helgelangen/TTT4212/Documentation/tex/10_Appendix.tex

\chapter{Schematics and layout}

  \begin{figure}[h]
	  \centering
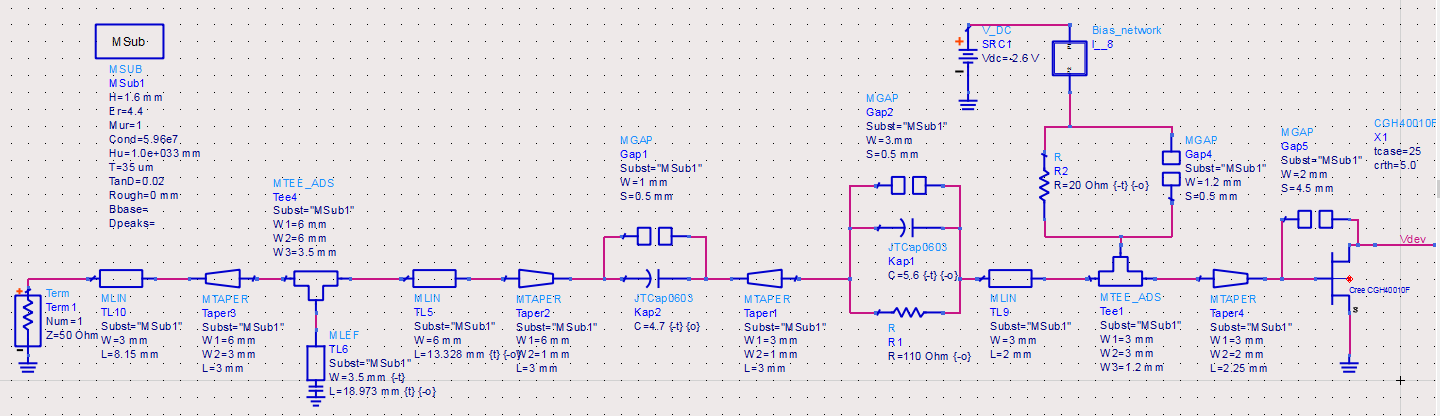
[picture p10: Documentation/img/Circuit_input.PNG]
	  
	  \caption{Input portion of amplifier circuit with S-parameter terminal}
	  \label{fig:Schem_Input}
  \end{figure}

  \begin{figure}[H]
	  \centering
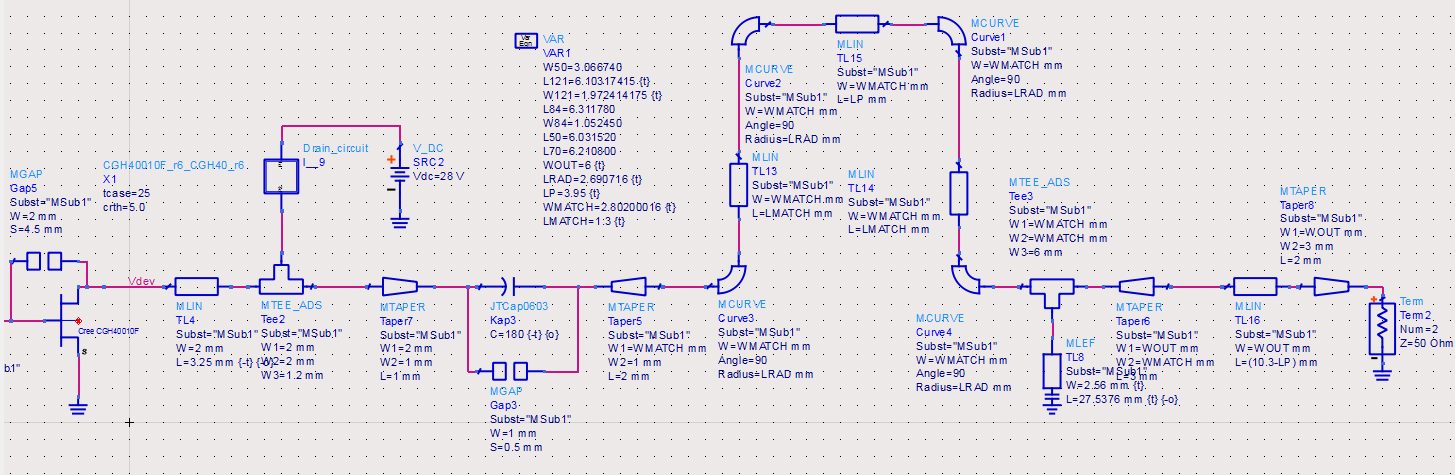
[picture p11: Documentation/img/Circuit_output.PNG]
	  
	  \caption{Output portion of amplifier circuit with S-parameter terminal}
	  \label{fig:Schem_Output}
  \end{figure}

  \begin{figure}[h]
	  \centering
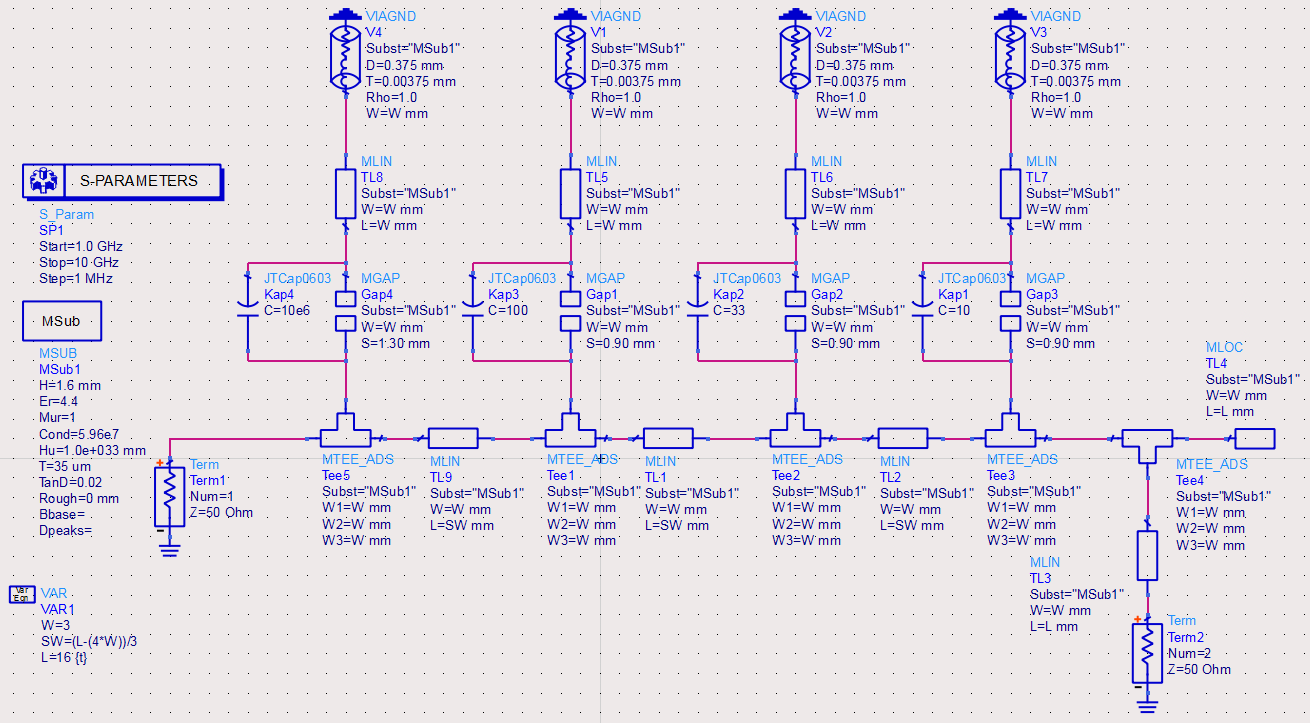
[picture p12: Documentation/Inbox/Bias_filter_two_port.PNG]
	  
	  \caption{Schematics of input and output bias network}
	  \label{fig:Schem_Bias}
  \end{figure}

  \begin{figure}[h]
	  \centering
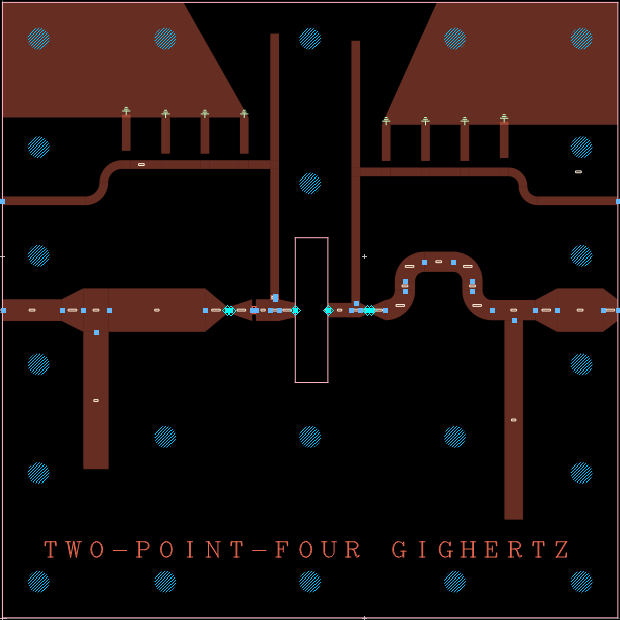
[picture p13: Documentation/img/Layout_ads.PNG]
	  
	  \caption{PCB layout}
	  \label{fig:Layout}
  \end{figure}

\chapter{Additional graphs}

  \begin{figure}[h]
	  \centering
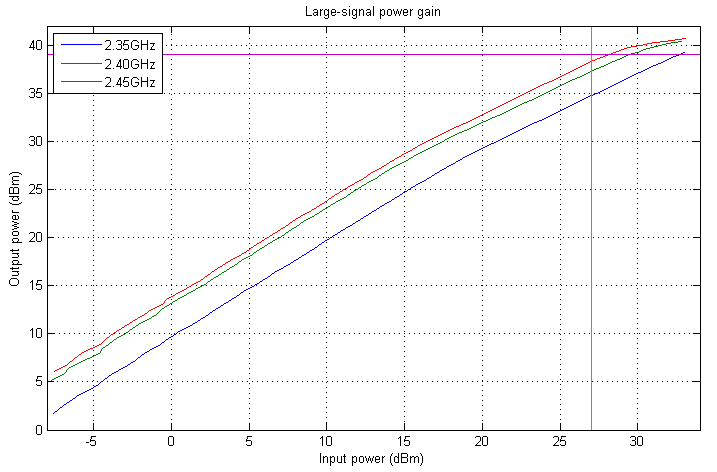
[picture p14: Documentation/img/Power_Out_1tone.png]
	  
	  \caption{Measured output power at three different frequencies}
	  \label{fig:Meas_Pout}
  \end{figure}

  \begin{figure}[H]
	  \centering
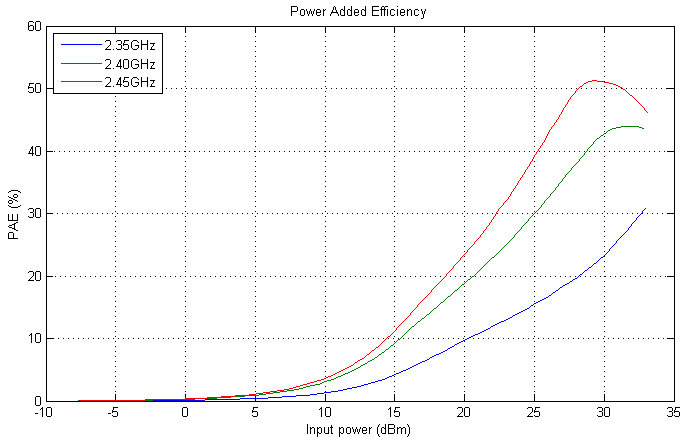
[picture p15: Documentation/img/Power_Added_Efficiency.png]
	  
	  \caption{Measured power added efficiency at three different frequencies}
	  \label{fig:Meas_Pae}
  \end{figure}
