helgelangen/TTT4212/Documentation/tex/title.tex

\begin{titlepage}

	\begin{center}~
		\\[5cm]

		~
		\\[0.3cm]
		\textsc{ Department of Electronics and Telecommunications}~
		\\[2cm]

		{ \huge \bfseries TTT4212 RF/Microwave Design and Measurement Techniques \\[0.5cm]
		Term Project Fall 2014 }~
		\\[1.5cm]

		{ \LARGE J\o rn Fr\o ysa, Helge Langen, Lars-Arne Larsen}
	\end{center}

\end{titlepage}
