helgelangen/TTT4212/Documentation/RF-present.pdf

## Design of power amplifier

- Design choices
- Bias/drain-network
- Stabillity
- Matching
- Layout
- Results

## Design choices

- Class AB
- Efficiency
- Gain
- Stubs for matching

## Bias/drain-network

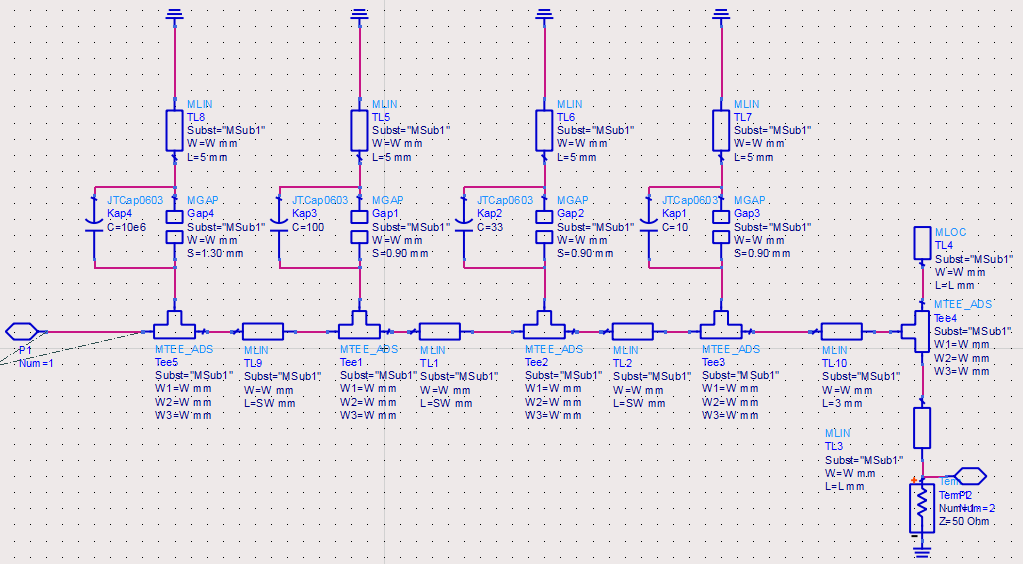
[picture p16: figure]

## Stabillity schematic

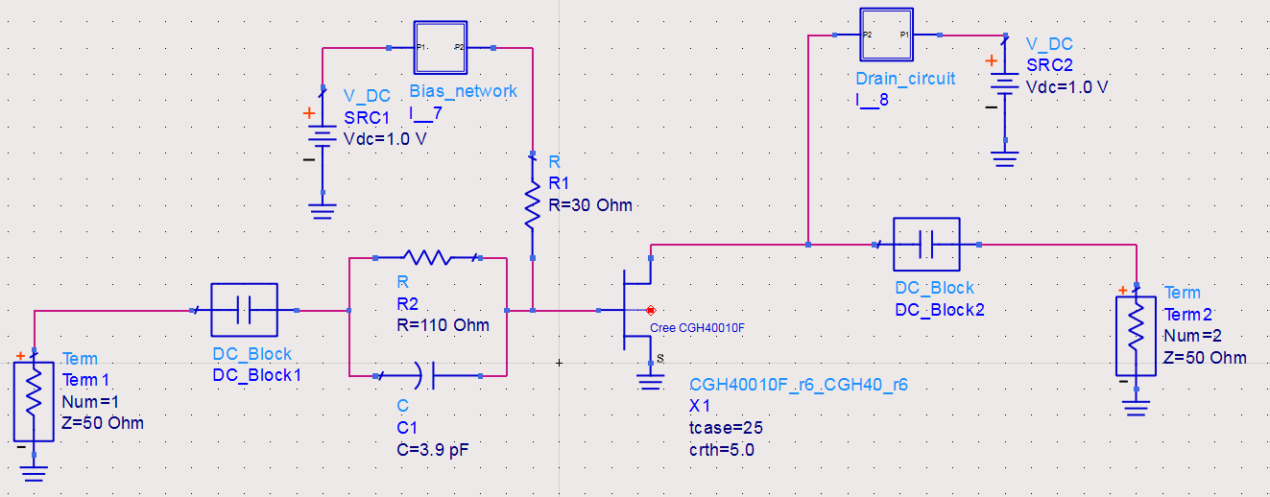
[picture p17: figure]

## Stabillity before-after

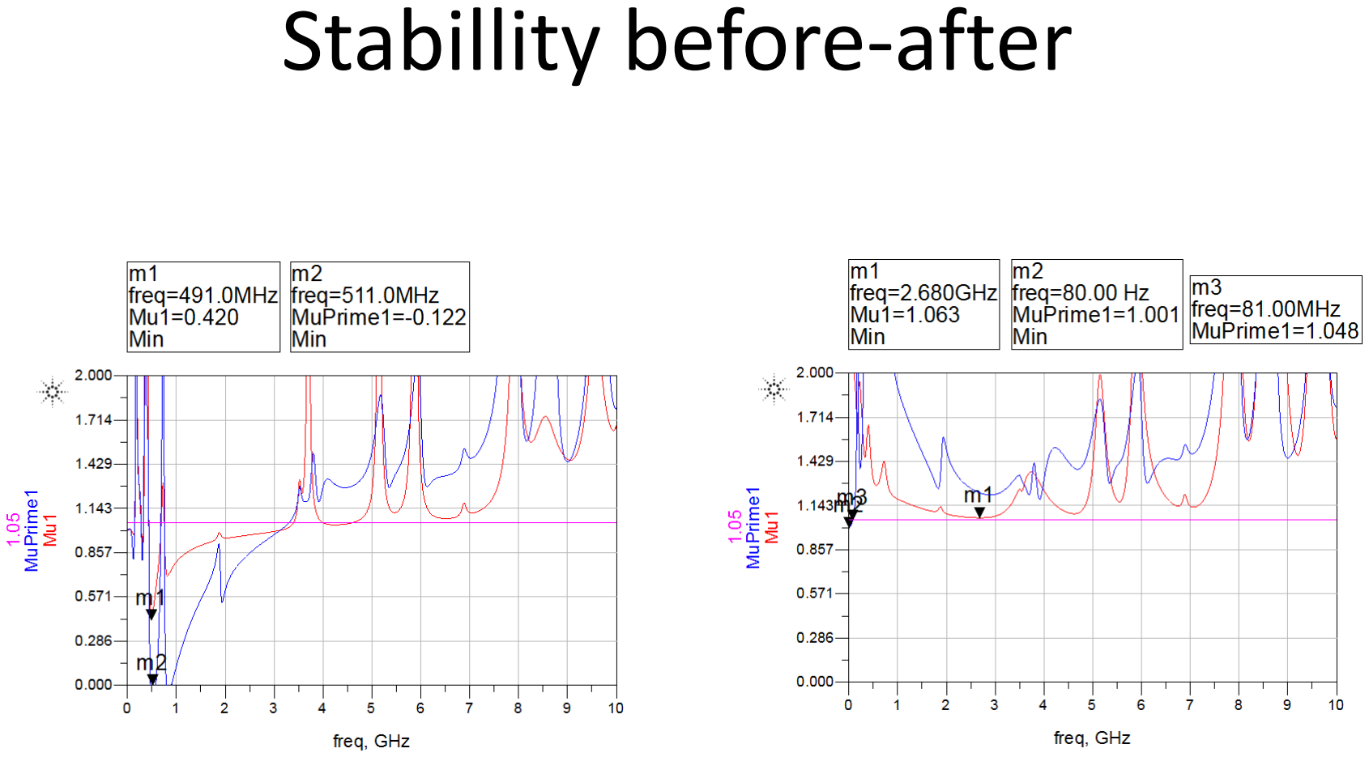
[picture p18: page 5]

## Matching schematic

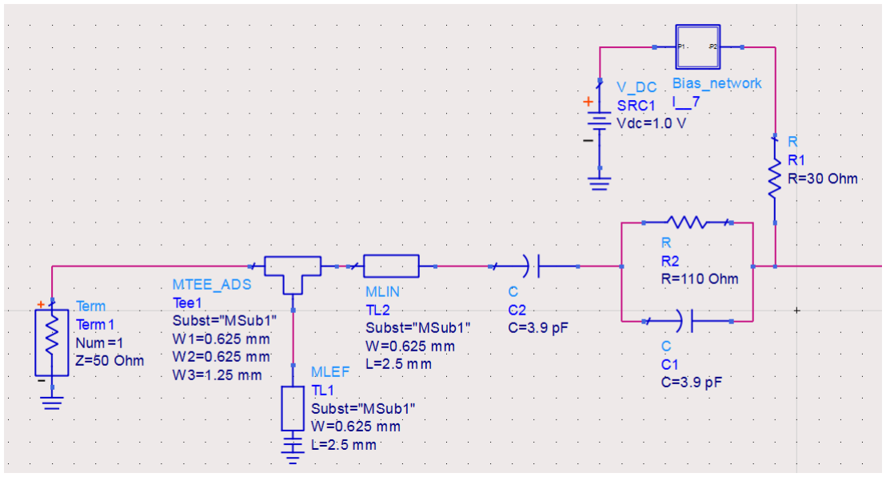
[picture p19: figure]

## Matching before-after

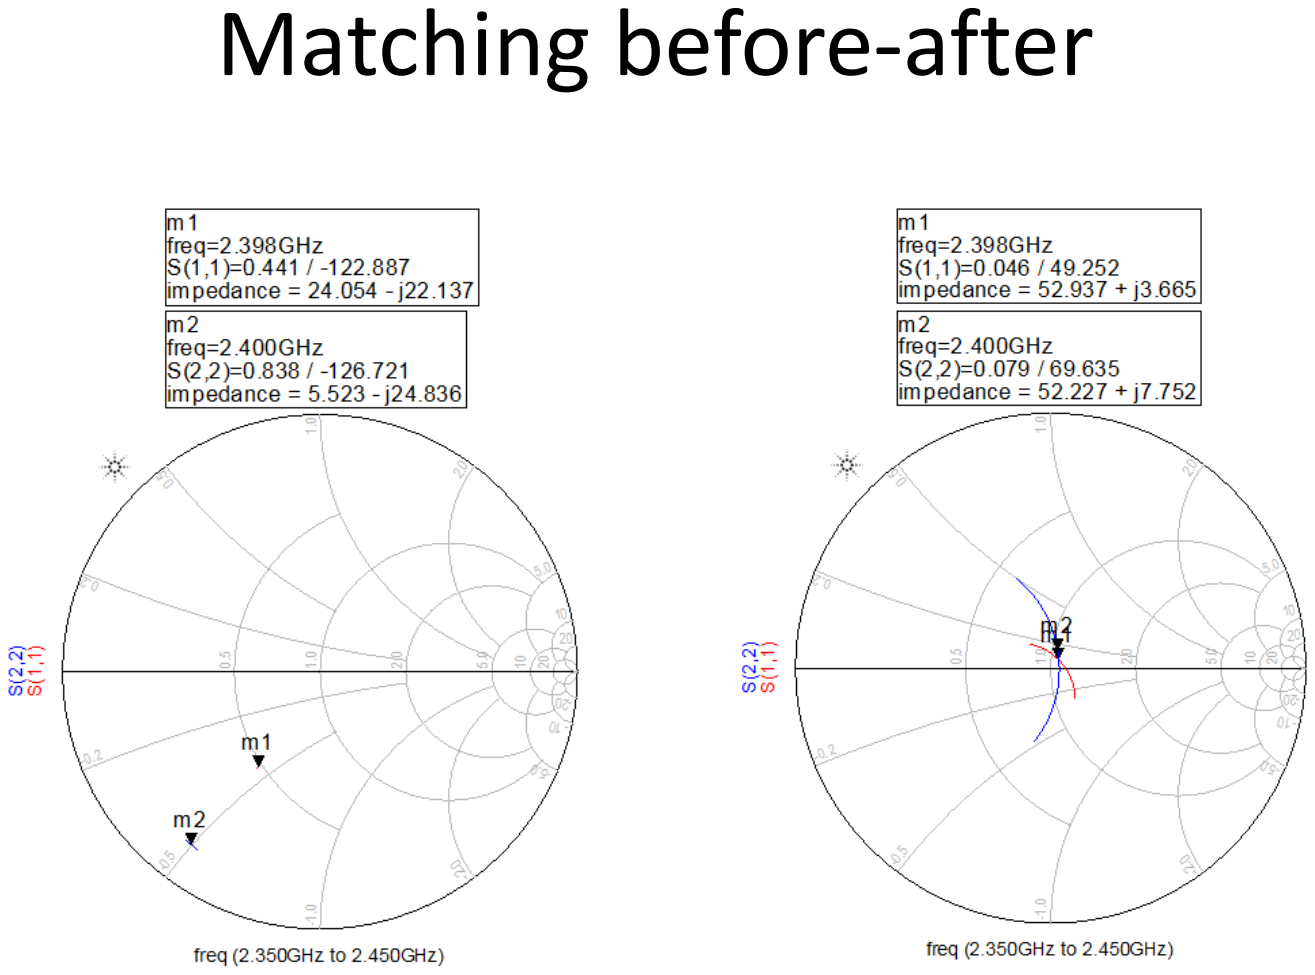
[picture p20: page 7]

## Layout

- Conversion to real components
- One at a time
- Tuned values
- Geometrical restrictions

## Schematic input


## Schematic output

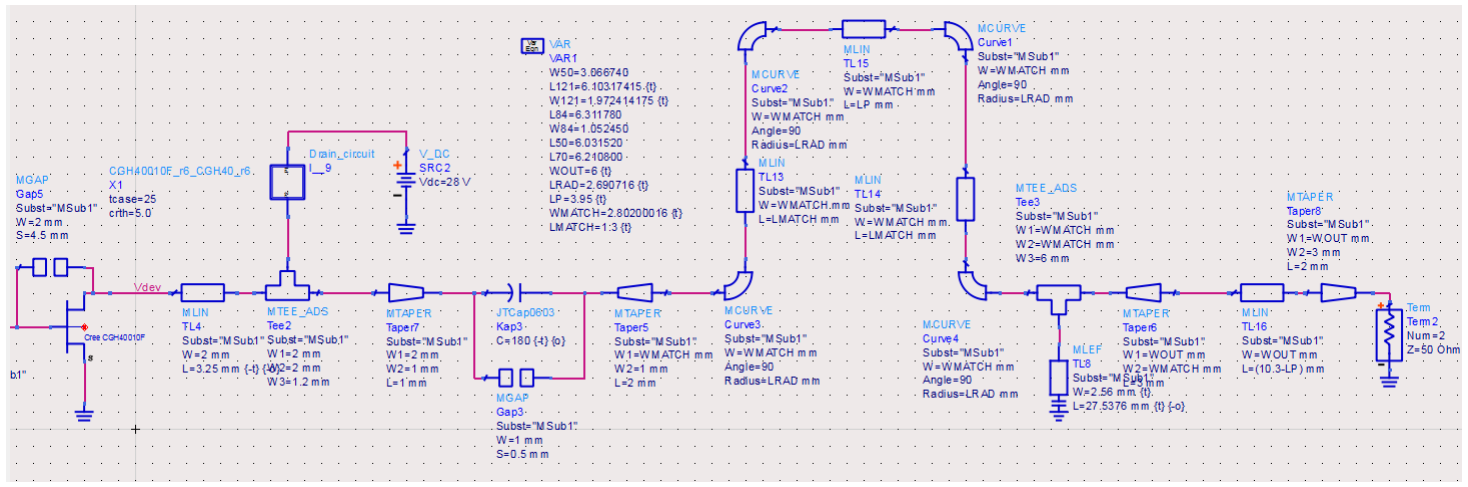
[picture p21: figure]

## Layout


## Results

Parameter | 2.35GHz | 2.40GHz | 2.45GHz | Requirement
Small-signal gain | 10.79dB | 14.08dB | 15.74dB | >13dB
Output power with 27dBm input | 34.73dBm | 37.17dBm | 38.37dBm | >39dBm
Power added efficiency | 18.26% | 35.02% | 46.99% | NA
Third order intermodulation distortion | | High: -22.41dBc Low: -22.45dBc

## Large-signal power gain


## Small-signal gain

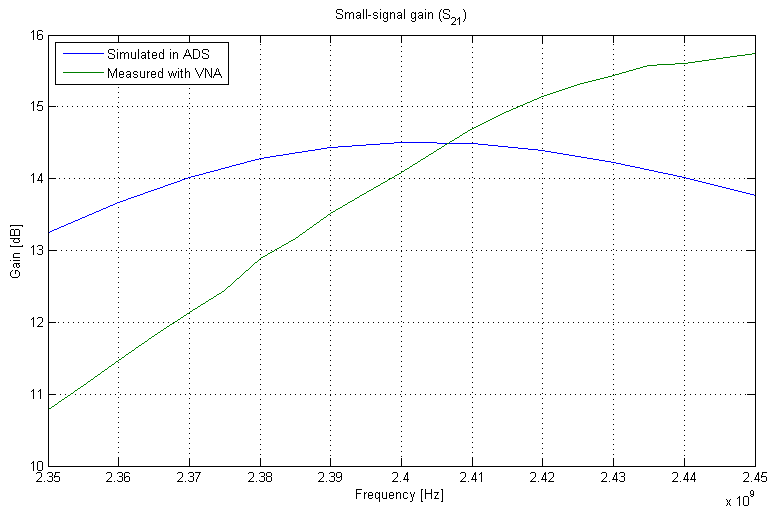
[picture p22: figure]

## Conclusion

- Unconditionally stable
- Decent efficiency
- Good intermodulation rejection
- Gain slightly off frequency wise
- Permittivity not exact

## Questions?
