helgelangen/TTT4212/Documentation/img/Bias_filter_one_port_s_parm.PNG

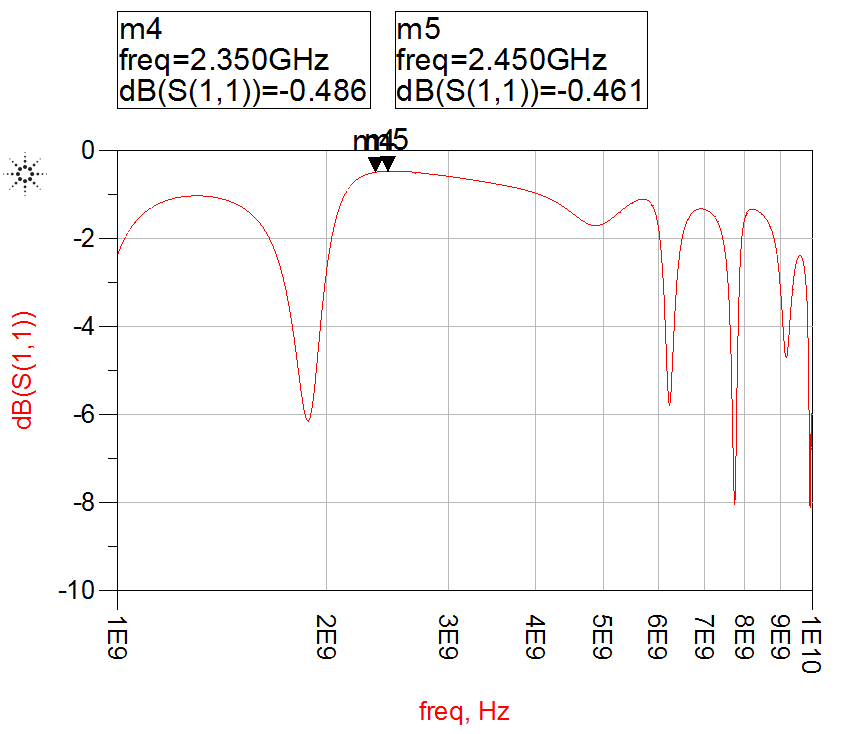
Documentation/img/Bias_filter_one_port_s_parm.PNG
