helgelangen/TTT4212/Documentation/img/Layout_red.PNG

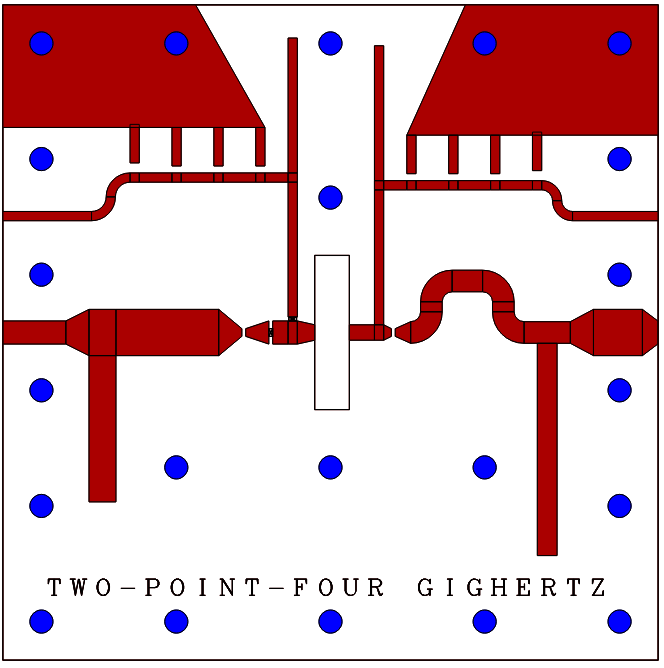
Documentation/img/Layout_red.PNG
