helgelangen/TTT4212/Documentation/img/Linearity_curve.jpg

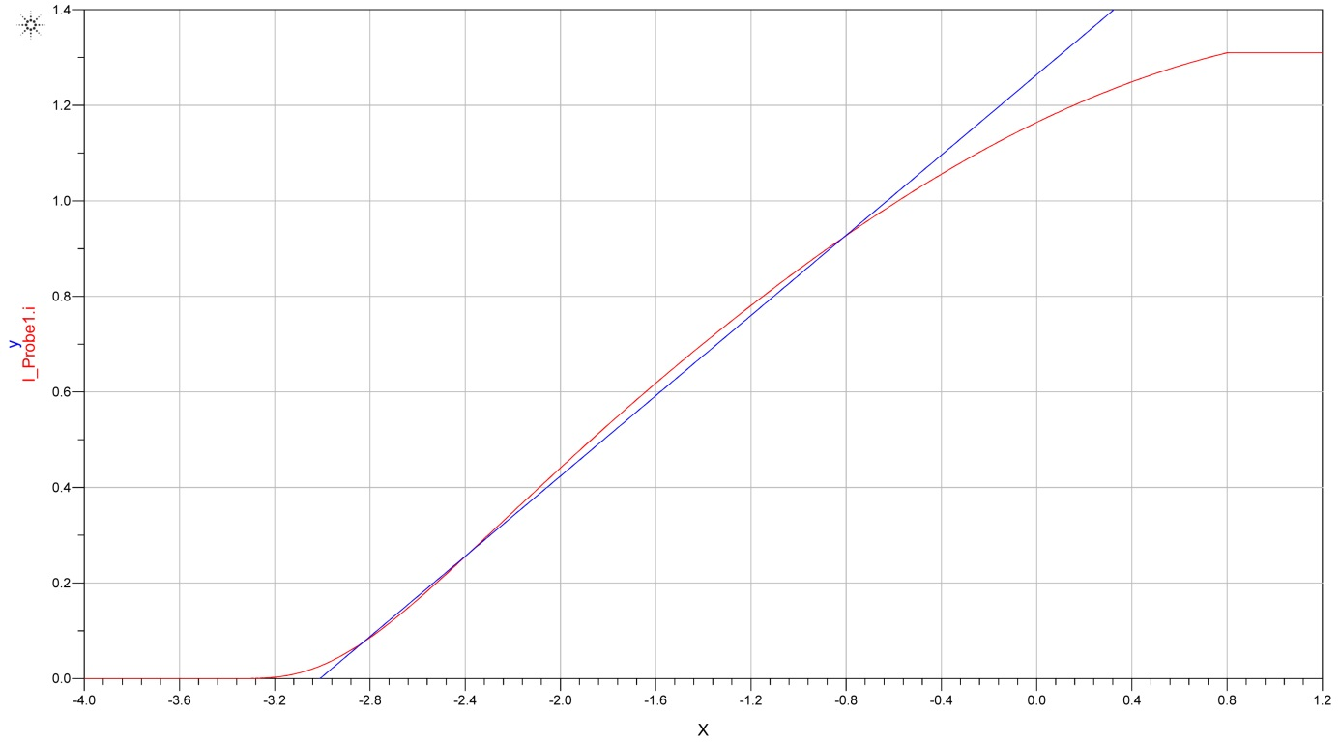
Documentation/img/Linearity_curve.jpg
