helgelangen/TTT4212/Documentation/img/Matching_circuit.PNG

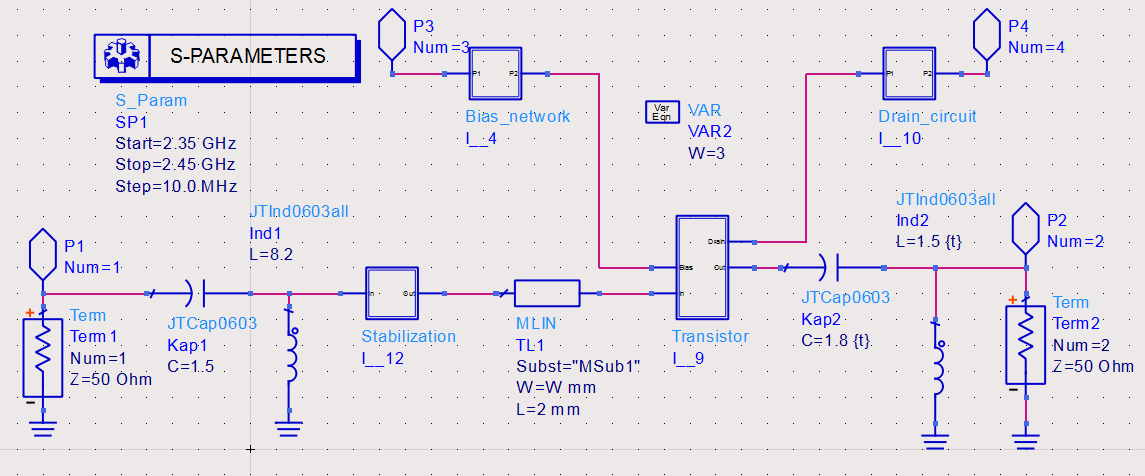
Documentation/img/Matching_circuit.PNG
