helgelangen/TTT4212/Documentation/img/Matching_smith_chart.PNG

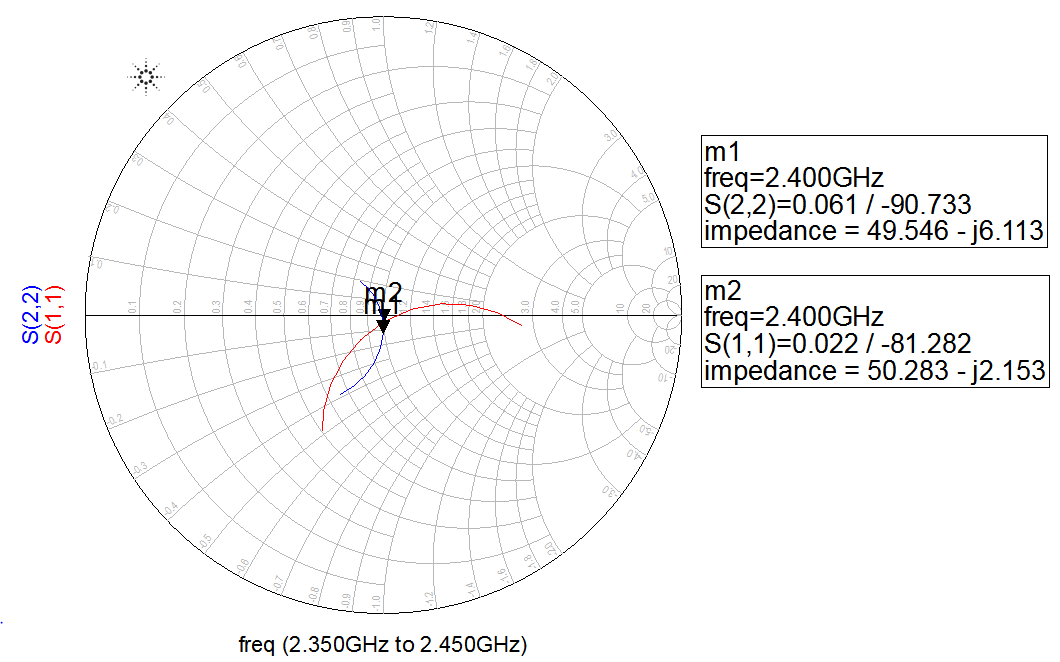
Documentation/img/Matching_smith_chart.PNG
