helgelangen/TTT4212/Documentation/img/Sim_TOIMD.PNG

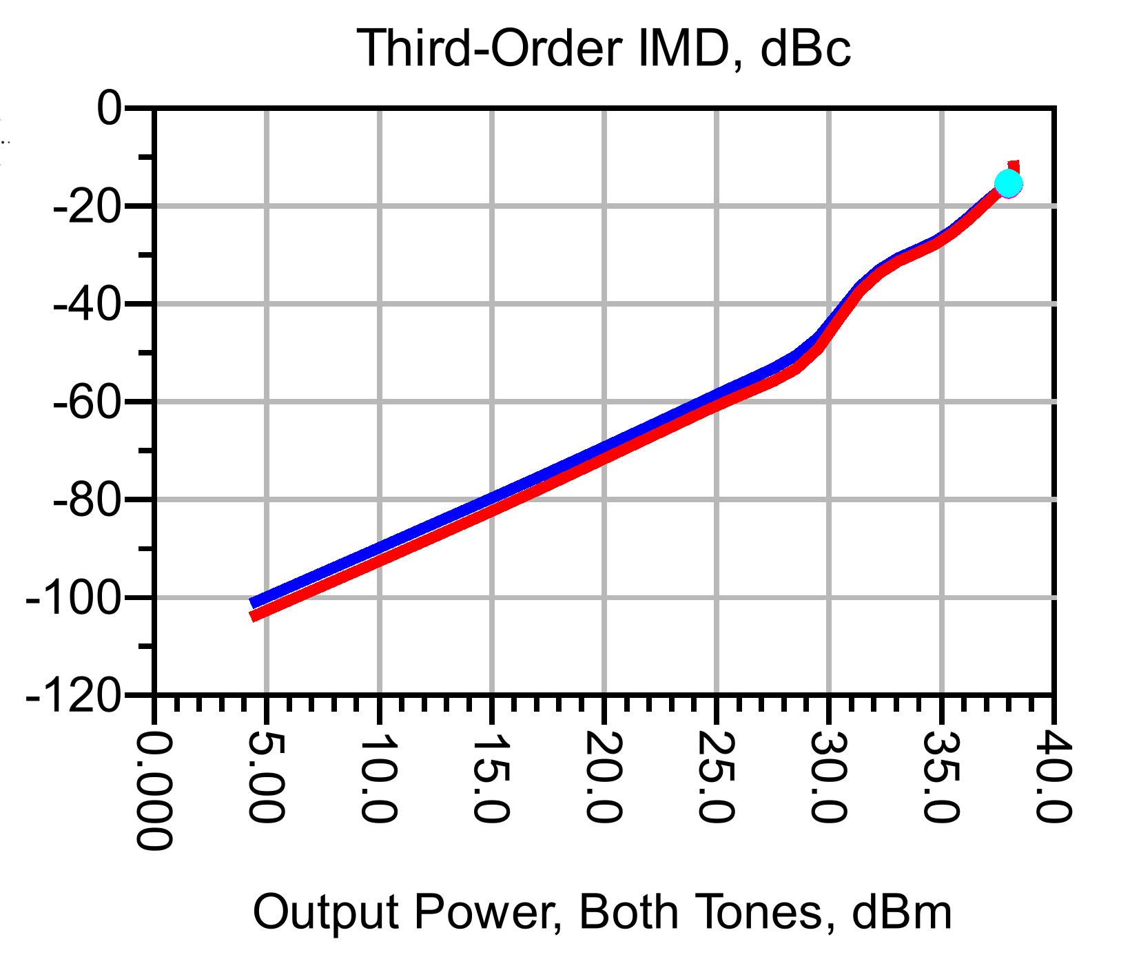
Documentation/img/Sim_TOIMD.PNG
