helgelangen/TTT4212/Documentation/img/Small_signal_gain_matched.PNG

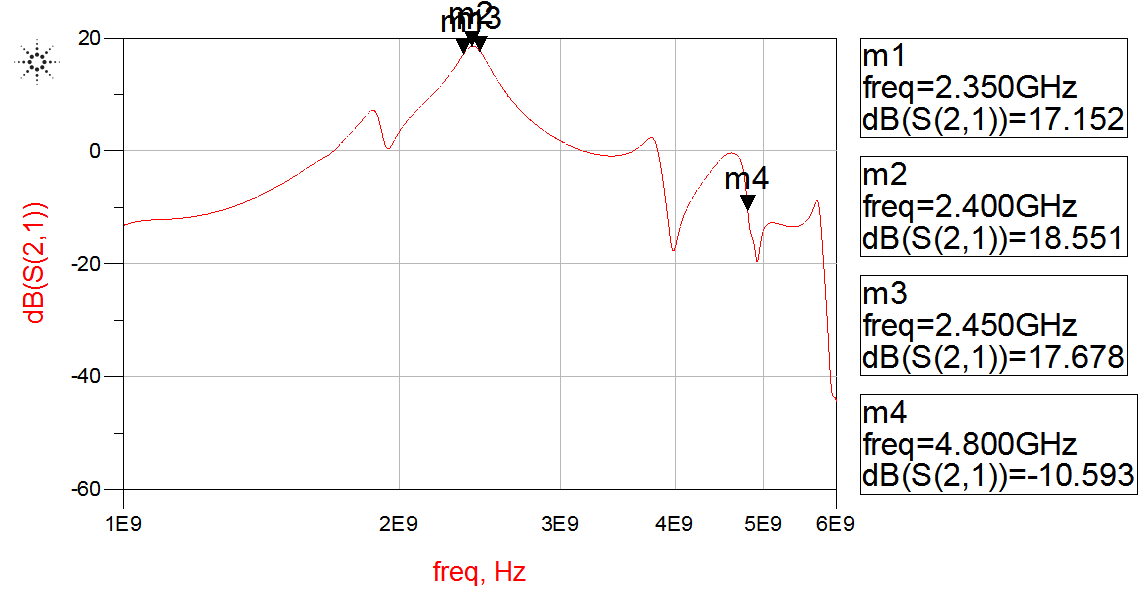
Documentation/img/Small_signal_gain_matched.PNG
