helgelangen/TTT4212/Documentation/img/Stabilization_circuit.PNG

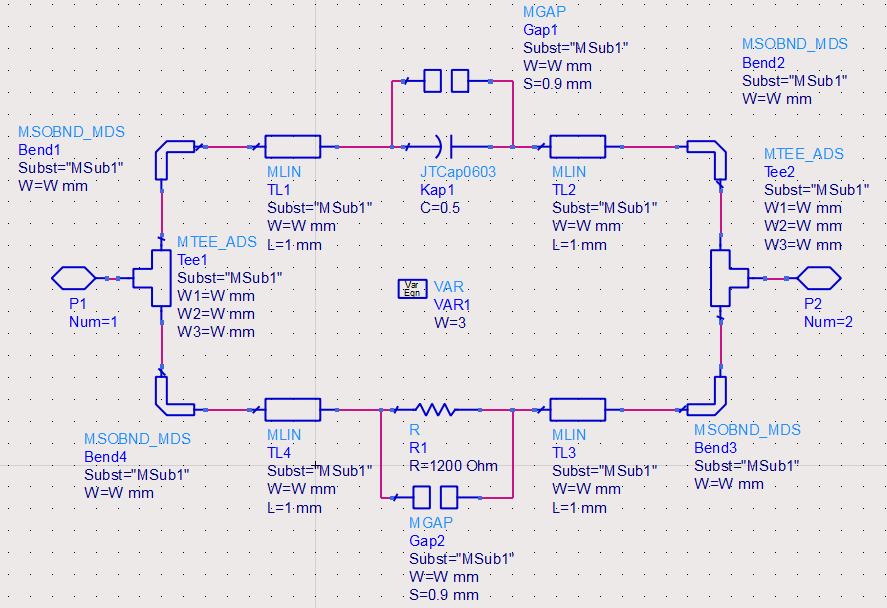
Documentation/img/Stabilization_circuit.PNG
