helgelangen/TTT4212/Documentation/Inbox/Matching_gain_plot.PNG

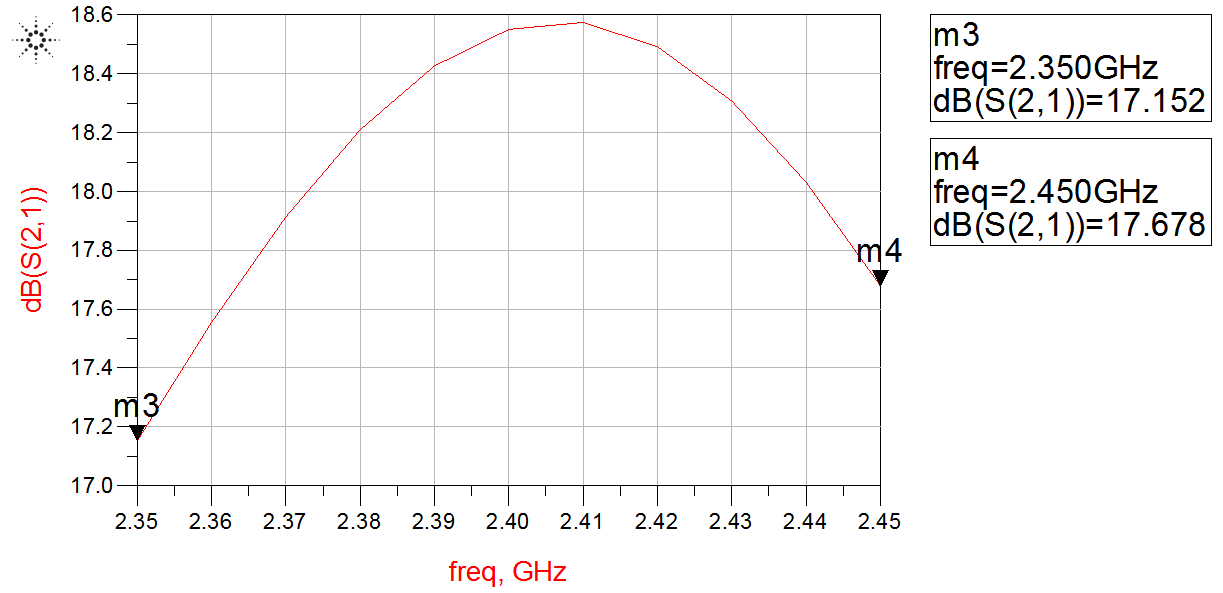
Documentation/Inbox/Matching_gain_plot.PNG
