helgelangen/TTT4212/Documentation/Inbox/Small_signal_gain_zoomed.PNG

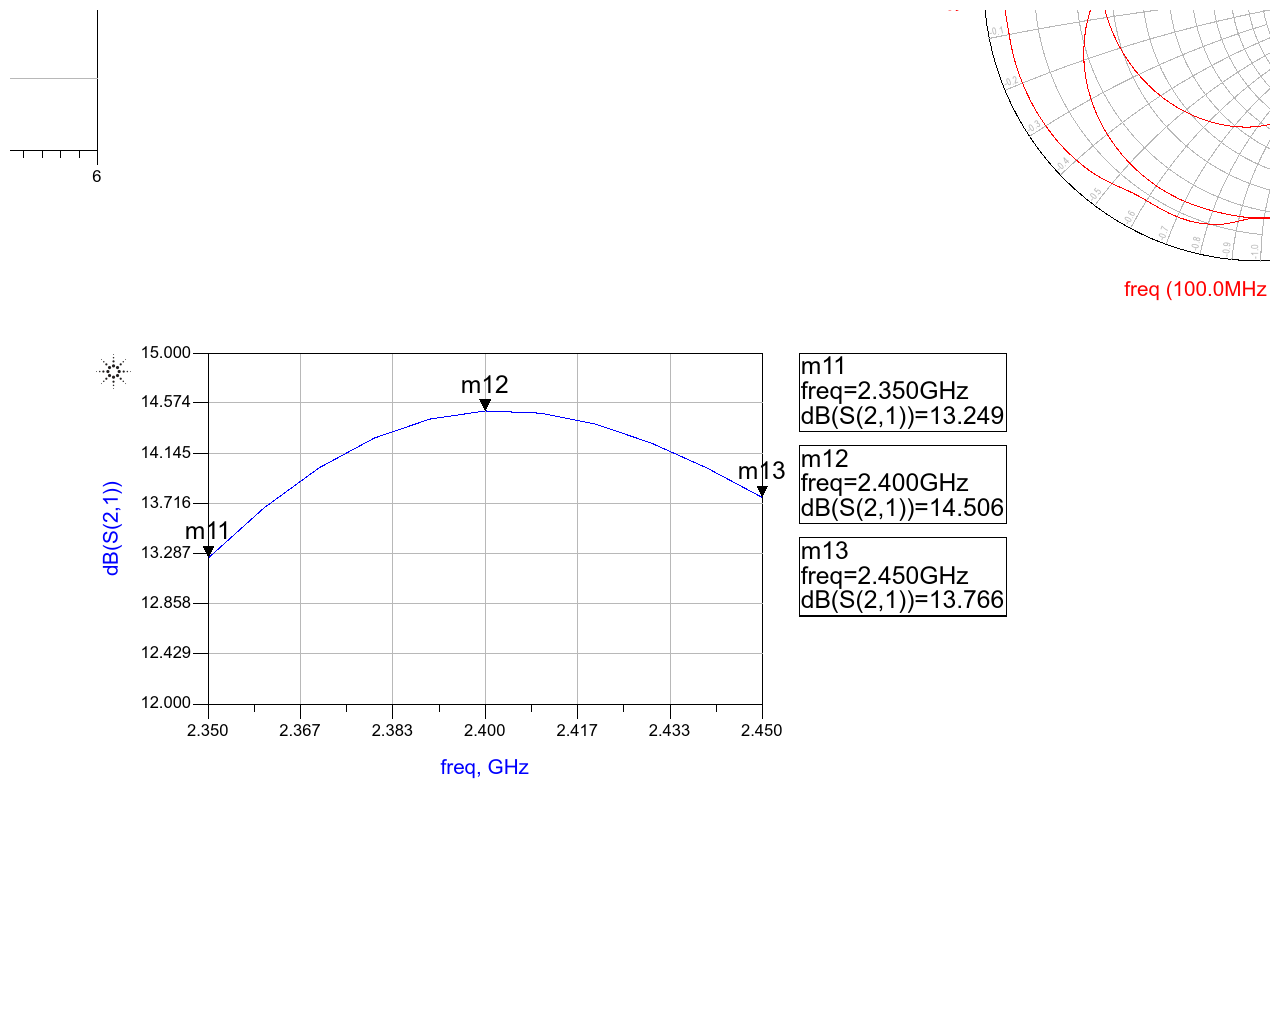
Documentation/Inbox/Small_signal_gain_zoomed.PNG
