helgelangen/TTT4212/Documentation/Inbox/Stability_V2.PNG

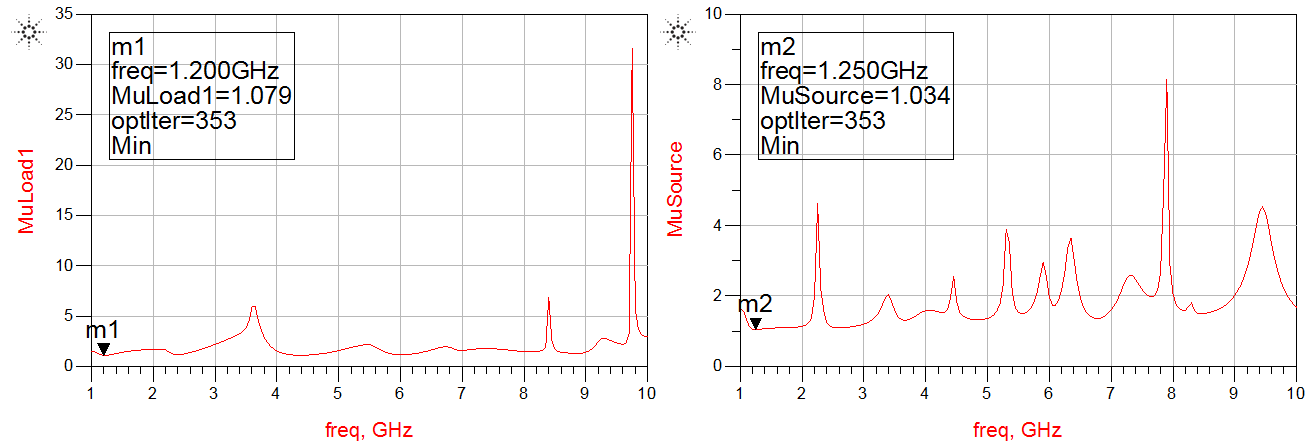
Documentation/Inbox/Stability_V2.PNG
