helgelangen/TTT4212/Documentation/Inbox/Stabilization_simulation.PNG

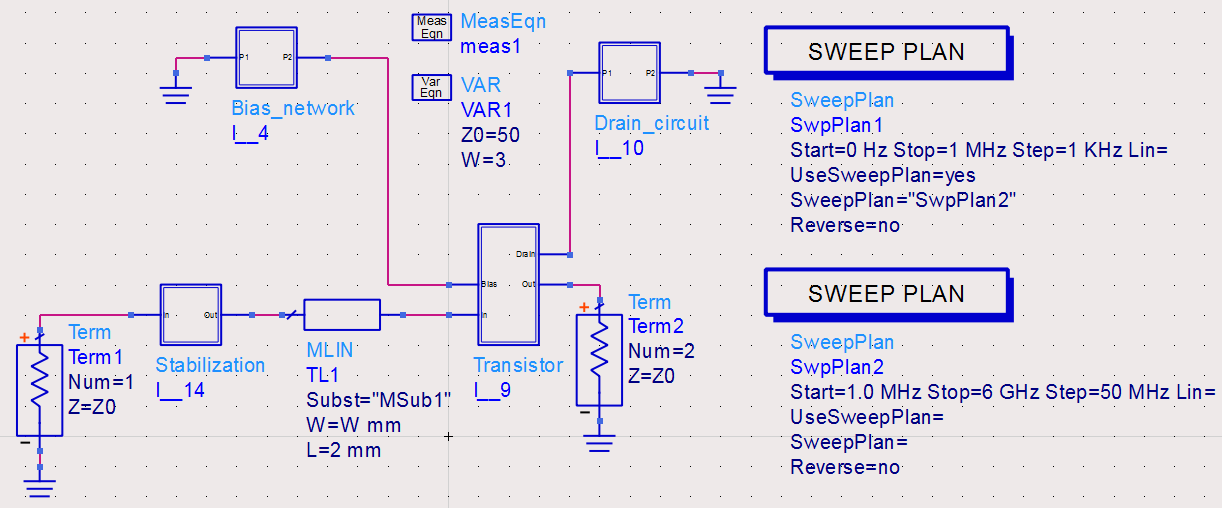
Documentation/Inbox/Stabilization_simulation.PNG
