helgelangen/TTT4212/Matlab/Power_Added_Efficiency.png

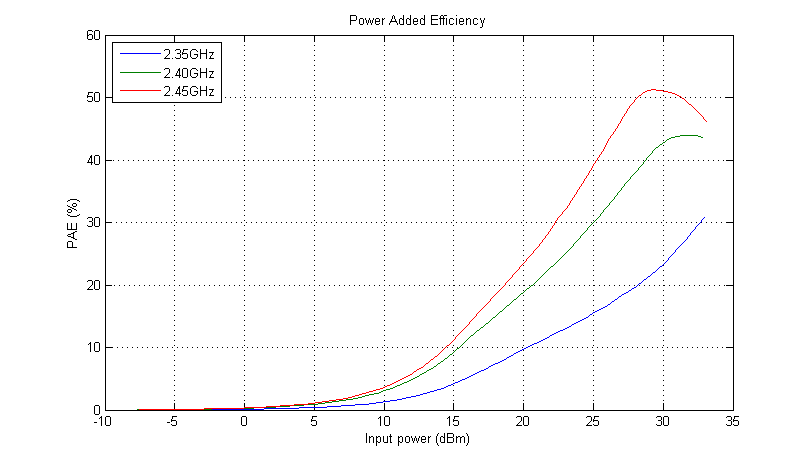
Matlab/Power_Added_Efficiency.png
