helgelangen/TTT4212/Matlab/Power_Out_1tone.png

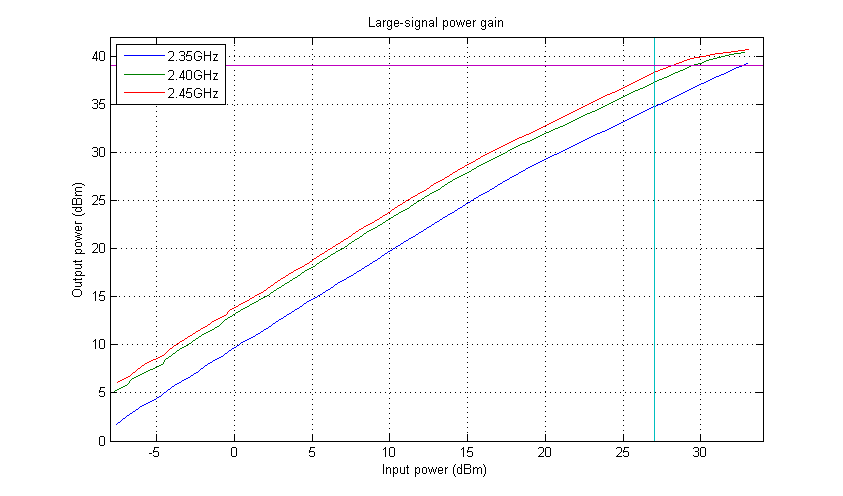
Matlab/Power_Out_1tone.png
