helgelangen/TTT4212/Matlab/S21_meas_sim.png

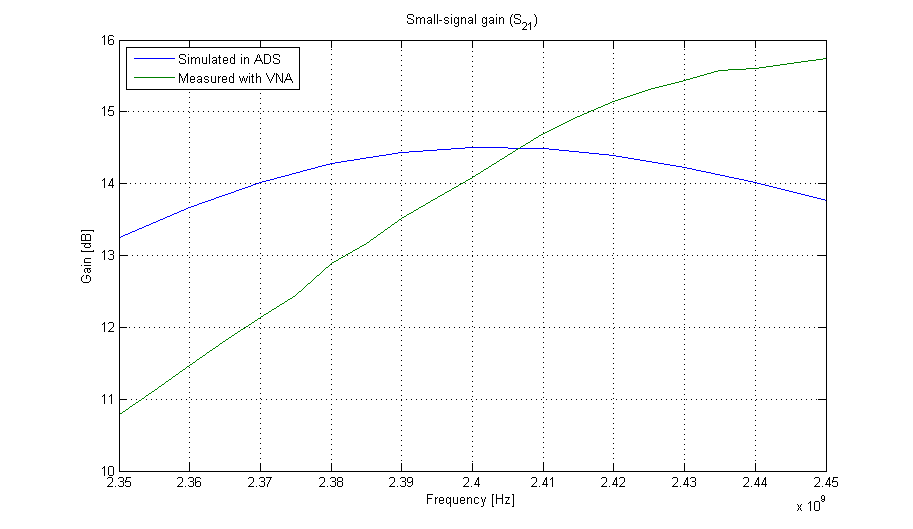
Matlab/S21_meas_sim.png
