helgelangen/TTT4212/Matlab/TOIMD_meas.png

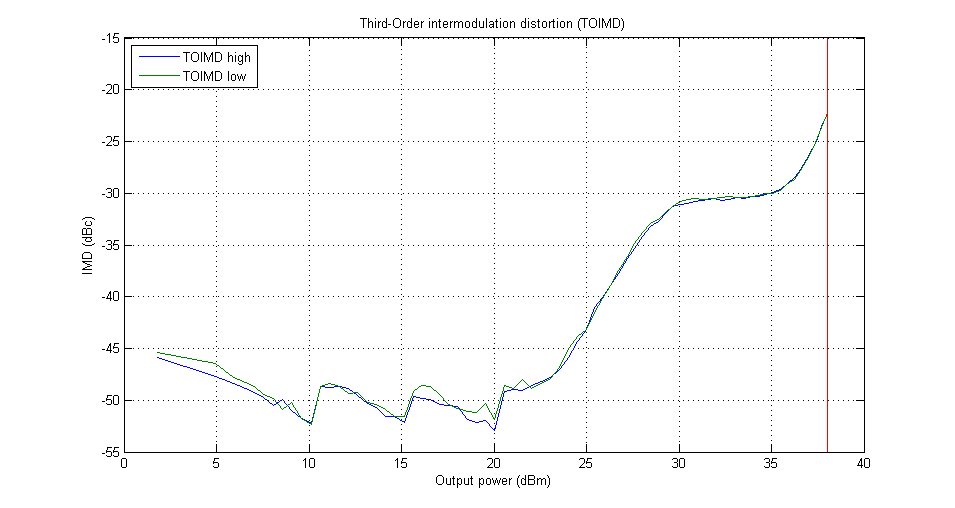
Matlab/TOIMD_meas.png
