helgelangen/TTT4212/Matlab/Sparam_measured_angS21.csv

 -1.374147686223567E2
 -1.238245583513888E2
 -1.248798137128175E2
 -1.258352716890455E2
 -1.272406625861568E2
 -1.275742546883390E2
 -1.287676880600730E2
 -1.280727656297757E2
 -1.282327360418579E2
 -1.284773182528932E2
 -1.296655410204547E2
 -1.277214079313562E2
 -1.261719925765423E2
 -1.243613998822899E2
 -1.177606096111111E2
 -1.144923908152847E2
 -1.033121898289514E2
 -9.436482170527597E1
 -8.388718173269510E1
 -7.095104077685973E1
 -6.103316304198397E1
 -4.977655715962779E1
 -4.355630413508563E1
 -3.908186923545928E1
 -3.576696882896782E1
 -3.243746585408600E1
 -3.316596306889390E1
 -3.020806451105506E1
 -3.047853570135779E1
 -3.241391172129386E1
 -3.142653323354056E1
 -3.239616198033674E1
 -3.471206247010057E1
 -3.645404926836806E1
 -3.745037322450605E1
 -3.854707452572501E1
 -4.002787572731059E1
 -4.169370879268980E1
 -4.235731843850920E1
 -4.377003160164669E1
 -4.570372203046557E1
 -4.758446934236196E1
 -4.835563894951342E1
 -5.023920576094715E1
 -5.302887609000705E1
 -5.563617048041810E1
 -5.733652953252825E1
 -5.892028293544730E1
 -6.163906983036319E1
 -6.266196333476692E1
 -6.417432729864269E1
 -6.639906295923399E1
 -6.770074585727058E1
 -7.046406945903911E1
 -7.263064637816412E1
 -7.456535935978278E1
 -7.709985747759558E1
 -7.934877964724714E1
 -8.140282247909644E1
 -8.398428419339530E1
 -8.672972194054358E1
 -8.989054243752766E1
 -9.221830009915941E1
 -9.528482065970066E1
 -9.817589527987069E1
 -1.019474600971678E2
 -1.043903667228961E2
 -1.077703286308440E2
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
 -6.595039898479141E1
 -6.778483176719688E1
 -6.986306050603537E1
 -7.214818221324356E1
 -7.283528214102151E1
 -7.486203401771462E1
 -7.536433623400508E1
 -7.753986172078074E1
 -8.171300436272745E1
 -7.926401251137708E1
 -8.110124052704623E1
 -8.235379775162957E1
 -8.346150130632171E1
