helgelangen/TTT4212/Matlab/Sparam_measured_freq.csv

 2.000000000000000E9
 2.005000000000000E9
 2.010000000000000E9
 2.015000000000000E9
 2.020000000000000E9
 2.025000000000000E9
 2.030000000000000E9
 2.035000000000000E9
 2.040000000000000E9
 2.045000000000000E9
 2.050000000000000E9
 2.055000000000000E9
 2.060000000000000E9
 2.065000000000000E9
 2.070000000000000E9
 2.075000000000000E9
 2.080000000000000E9
 2.085000000000000E9
 2.090000000000000E9
 2.095000000000000E9
 2.100000000000000E9
 2.105000000000000E9
 2.110000000000000E9
 2.115000000000000E9
 2.120000000000000E9
 2.125000000000000E9
 2.130000000000000E9
 2.135000000000000E9
 2.140000000000000E9
 2.145000000000000E9
 2.150000000000000E9
 2.155000000000000E9
 2.160000000000000E9
 2.165000000000000E9
 2.170000000000000E9
 2.175000000000000E9
 2.180000000000000E9
 2.185000000000000E9
 2.190000000000000E9
 2.195000000000000E9
 2.200000000000000E9
 2.205000000000000E9
 2.210000000000000E9
 2.215000000000000E9
 2.220000000000000E9
 2.225000000000000E9
 2.230000000000000E9
 2.235000000000000E9
 2.240000000000000E9
 2.245000000000000E9
 2.250000000000000E9
 2.255000000000000E9
 2.260000000000000E9
 2.265000000000000E9
 2.270000000000000E9
 2.275000000000000E9
 2.280000000000000E9
 2.285000000000000E9
 2.290000000000000E9
 2.295000000000000E9
 2.300000000000000E9
 2.305000000000000E9
 2.310000000000000E9
 2.315000000000000E9
 2.320000000000000E9
 2.325000000000000E9
 2.330000000000000E9
 2.335000000000000E9
 2.340000000000000E9
 2.345000000000000E9
 2.350000000000000E9
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
 2.935000000000000E9
 2.940000000000000E9
 2.945000000000000E9
 2.950000000000000E9
 2.955000000000000E9
 2.960000000000000E9
 2.965000000000000E9
 2.970000000000000E9
 2.975000000000000E9
 2.980000000000000E9
 2.985000000000000E9
 2.990000000000000E9
 2.995000000000000E9
 3.000000000000000E9
