helgelangen/TTT4212/(commit log)

2014-09-24 Initial commit of ADS files
    [de_sim.cfg, hpeesofsim.cfg]
2014-09-24 Added 2GHz amp schematics
    [de_sim.cfg, hpeesofsim.cfg]
2014-09-24 Added dummy file to data folder
    [de_sim.cfg, hpeesofsim.cfg]
2014-09-24 la til noen motstander og spoler
2014-09-24 Added resistors v2
    [de_sim.cfg, hpeesofsim.cfg]
2014-09-24 Removed stupid resistors
    [de_sim.cfg, hpeesofsim.cfg]
2014-09-24 Fixed libraries
    [SYM_CGH40006P_r6_CGH40_r6.dsn, SYM_CGH40006S_r6_CGH40_r6.dsn, SYM_CGH40010F_r6_CGH40_r6.dsn, SYM_CGH40025F_r6_CGH40_r6.dsn, SYM_CGH40045F_r6_CGH40_r6.dsn, SYM_CGH40090PP_r6_CGH40_r6.dsn, SYM_CGH40120F_r6_CGH40_r6.dsn, SYM_CGH40180PP_r6a_CGH40_r6.dsn]
2014-09-24 Attempting correction
    [de_sim.cfg, hpeesofsim.cfg]
2014-09-24 New attempts
    [SYM_CGH40006P_r6_CGH40_r6.dsn, SYM_CGH40006S_r6_CGH40_r6.dsn, SYM_CGH40010F_r6_CGH40_r6.dsn, SYM_CGH40025F_r6_CGH40_r6.dsn, SYM_CGH40045F_r6_CGH40_r6.dsn, SYM_CGH40090PP_r6_CGH40_r6.dsn, SYM_CGH40120F_r6_CGH40_r6.dsn, SYM_CGH40180PP_r6a_CGH40_r6.dsn]
2014-09-25 DC_workpoint
    La til DC workpointkrets og simulering
    [de_sim.cfg, hpeesofsim.cfg]
2014-09-25 FET_IV_Gm_powercalcs
    La til simulering fra designguide for DC
    [dds.cfg, de_sim.cfg, hpeesofsim.cfg]
2014-09-26 Added picture of bias-point, added simulation of AC-filter
    [dds.cfg, de_sim.cfg, hpeesofsim.cfg]
2014-09-26 Did some more simulations on bias-filter
    [dds.cfg, de_sim.cfg, hpeesofsim.cfg]
2014-09-26 did some simulations
    [de_sim.cfg]
2014-09-27 New and working ADS workspace
    [de_sim.cfg, hpeesofsim.cfg]
2014-09-30 Added new transistor-model, added new matching circuit
    [dds.cfg, de_sim.cfg, hpeesofsim.cfg]
2014-10-01 Stabillity measurements
    Created new design with stabillity measurements and designed a new
    amplifier with stable conditions.
    [dds.cfg, de_sim.cfg, hpeesofsim.cfg, linecalc.cfg]
2014-10-02 Simulations
    Ran several simulations, fixed stability and (Hopefully) matching!
    [dds.cfg, de_sim.cfg, linecalc.cfg]
2014-10-03 COMPLETE!!
    Completed design for first delivery, removed unused designs. Added
    archive of complete workspace.
    [dds.cfg, de_sim.cfg]
2014-10-08 Round two!
    Added original model for transistor, modified bias network. New network
    for stabilization and matching.
    [de_sim.cfg, hpeesofsim.cfg]
2014-10-09 With_Help
    Modified bias/drain networks with help from Tømmer. Changed bias point
    to -2.6 volts.
    [dds.cfg, de_sim.cfg, hpeesofsim.cfg]
2014-10-14 Work
    Did some work!
    Amplifier done, filter on output missing!
    [dds.cfg, de_sim.cfg]
2014-10-19 Layout
    Added layout to design, made some corrections.
    [dds.cfg, hpeesofsim.cfg]
2014-10-24 Layout_finish
    Finished final detailes of layout
    [dds.cfg, de_sim.cfg, hpeesofsim.cfg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]
2014-11-06 Matlab
    Added matlab-folder
    [dds.cfg, de_sim.cfg]
2014-11-11 cleaned up documentation folder
    [Sparam_measured_angS21.csv, Sparam_measured_freq.csv, Sparam_measured_magS21.csv]
2014-11-12 Lars
    LArse
    [dds.cfg, de_sim.cfg]
2014-11-20 LArsa
    Lars
    [de_sim.cfg]
